PiMaker/MCPC-Hardware/FPGA/font/ExportedFont.bmp

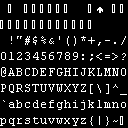
FPGA/font/ExportedFont.bmp
