PiMaker/MCPC-Hardware/(list of files, drawings)

Other design files:
Schematic and PCB/mcpcbus_pads.pcb
