PiMaker/MCPC-Hardware/Schematic and PCB/16bitbuffer.sch

## KiCad design Schematic and PCB/16bitbuffer.sch (2018-07-28, last stored version)

Schematic: 16bitbuffer.sch

Parts:
BufferA301: 74HC244
BufferB301: 74HC244
