PiMaker/MCPC-Hardware/Schematic and PCB/BidirectionalBuffer.sch

## KiCad design Schematic and PCB/BidirectionalBuffer.sch (2018-07-28, last stored version)

Schematic: BidirectionalBuffer.sch

Parts:
U201: SN74HC04N; DIP-14_W3mm; MPN SN74HC04N; Digi-Key_PN 296-1566-5-ND
U202: SN74HC08N; DIP-14_W3mm; MPN SN74HC08N; Digi-Key_PN 296-1570-5-ND

Notes on the sheet:
DIR low: 1 -> 0 DIR high: 0 -> 1
