PiMaker/MCPC-Hardware/(commit log)

2018-03-02 Implemented full compiler prototype
2018-03-03 Added VSCode plugin and made compiler more case-insensitive
2018-03-06 A lot of smaller fixes, work on a general testing .dig file, added hello_world.ma sample and sram.lib
2018-03-10 Added interpreter code prototype
2018-04-04 Added Schematic and PCB
    [16bitbuffer.sch, BidirectionalBuffer.sch, Schematic and PCB.kicad_pcb, Schematic and PCB.sch]
2018-08-26 Restructuring and new FPGA code
    [16bitbuffer.sch, BidirectionalBuffer.sch, mcpcbus_pads.pcb]
2018-09-17 Holy crapola, this shit actually works!
    Successfully assembled MCPC assembler can now be executed on the
    FPGA, instructions set (as defined in doc.md) is fully
    implemented. Clockspeeds up to 12,5 MHz are running stable.
2018-10-20 Some fixes in the assembler regarding MSCR and change of NOT->XOR
    [Registers.sv, cpu_top.sv, main.sv]
2018-12-20 Added more tests and fixed old ones regarding bracketless M
2018-12-26 Fixed debugging and partially MEMR/MEMW
    [cpu_top.sv, debugging.sv, main.sv]
2018-12-27 Fixed an error condition in the assembler
2018-12-27 Fixed memory issue and got Hello World to work :)
    [cpu_top.sv]
2018-12-30 Preliminary version of interrupts and PS support
2018-12-30 Interrupts are somewhat working now
2018-12-31 Fixed a lot of things regarding IRQs and PS2
    [cpu_top.sv, hex_bus_display.v, main.sv]
2019-01-07 Small fix in assembler, more debugging towards working irqs
    [cpu_top.sv]
2019-01-10 Fixed VM interrupts and added tracing support
2019-01-13 Finally fixed the weird 0x9011 IRQ bug... and opened up 20 more
    [cpu_top.sv]
2019-01-25 Made lots of things prettier, began mVIRA OS implementation
    [keycode_table.ods]
2019-01-25 Doc update and custom bootloader_rom implementation (broken)
    [bootloader_rom.sv, cpu_top.sv, debugging.sv]
2019-01-26 Fixed bootloader_rom (ram now, but unused writes) and fixed irq crashes
    [bootloader_rom.sv, cpu_top.sv]
2019-02-05 Added promo material
2019-02-05 Added MCPC version register and Framebuffer reading
2019-02-08 Fixed keyboard bug related to faulty startup and no reset
    [main.sv]
